AdriTeixeHax/RTSpeed-Hardware/RTSpeed-KiCad/RTSpeed-KiCad.kicad_pcb

## KiCad design RTSpeed-KiCad/RTSpeed-KiCad.kicad_pcb (2025-10-25)

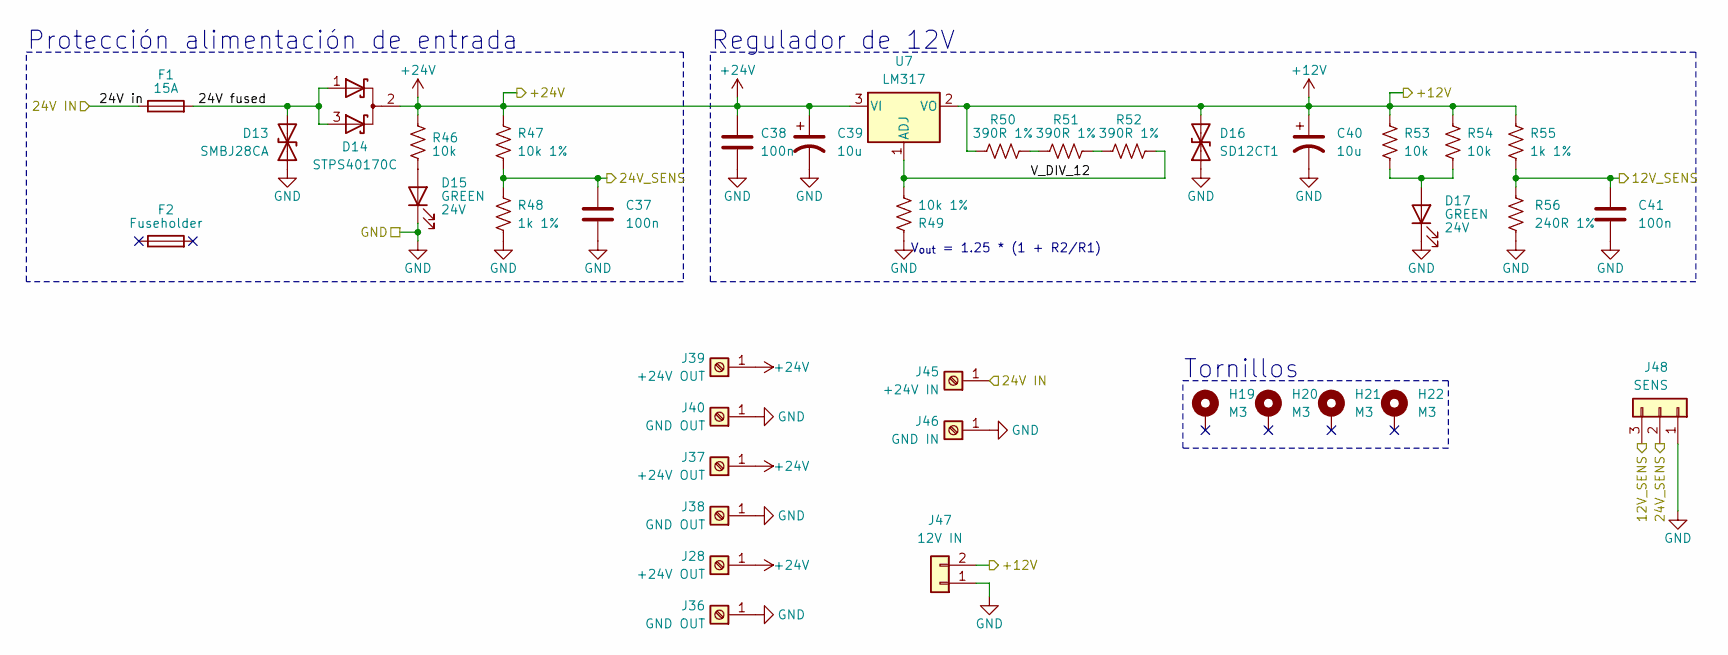
[picture p13: schematic Prot-24V-12V.kicad_sch]

Parts:
C37, C38, C41: 100n; C_0603_1608Metric; LCSC part C5137636
C39, C40: 10u; CP_Elec_4x5.4; LCSC part C72484
D13: SMBJ28CA; D_SMB; LCSC part C151259
D14: STPS40170C; TO-220-3_Vertical; LCSC part C222365
D15, D17: GREEN; LED_0805_2012Metric; LCSC part C965815
D16: SD12CT1; D_SOD-323_HandSoldering; LCSC part C328100
F1: 15A; Fuseholder_Automotive; LCSC part C151095
F2: Fuseholder; LCSC part C19727305
H19, H20, H21, H22: M3; MountingHole_3.2mm_M3
J28, J37, J39: +24V OUT; MountingHole_2.5mm_Pad_TopBottom
J36, J38, J40: GND OUT; MountingHole_2.5mm_Pad_TopBottom
J45: +24V IN; MountingHole_2.5mm_Pad_TopBottom
J46: GND IN; MountingHole_2.5mm_Pad_TopBottom
J47: 12V IN; JST_PH_B2B-PH-K_1x02_P2.00mm_Vertical
J48: SENS; JST_PH_B3B-PH-K_1x03_P2.00mm_Vertical
R46, R53, R54: 10k; R_0603_1608Metric; LCSC part C126901
R47, R49: 10k 1%; R_0603_1608Metric; LCSC part C126901
R48: 1k 1%; R_0603_1608Metric; LCSC part C103198
R50, R51, R52: 390R 1%; R_0603_1608Metric; LCSC part C3016257
R55: 1k 1%; R_0603_1608Metric; LCSC part C126901
R56: 240R 1%; R_0603_1608Metric; LCSC part C286579
U7: LM317; TO-220-3_Vertical; LCSC part C3014307

Connections:
+12V: C40.1, D16.2 (A2), J47.2, R50.1, R53.1, R54.1, R55.1, U7.2 (VO); also elsewhere on the board
+24V: C38.1, C39.1, D14.2 (K), J28.1, J37.1, J39.1, R46.1, R47.1, U7.3 (VI); also elsewhere on the board
/ADC/CH0: C37.1, J48.2, R47.2, R48.2; also elsewhere on the board
/ADC/CH1: C41.1, J48.3, R55.2, R56.1; also elsewhere on the board
/Protección 24V-12V/24V fused: D13.2 (A2), D14.1 (A), D14.3 (A), F1.2
/Protección 24V-12V/24V in: F1.1, J45.1; also elsewhere on the board
/Protección 24V-12V/V_DIV_12: R49.2, R52.2, U7.1 (ADJ)
GND: C37.2, C38.2, C39.2, C40.2, C41.2, D13.1 (A1), D15.1 (K), D16.1 (A1), D17.1 (K), J36.1, J38.1, J40.1, J46.1, J47.1, J48.1, R48.1, R49.1, R56.2; also elsewhere on the board
unnamed: D15.2 (A), R46.2
unnamed: D17.2 (A), R53.2, R54.2
unnamed: R50.2, R51.1
unnamed: R51.2, R52.1

Notes on the sheet:
Protección alimentación de entrada
V_{out} = 1.25 * (1 + R2/R1)
Regulador de 12V
Tornillos

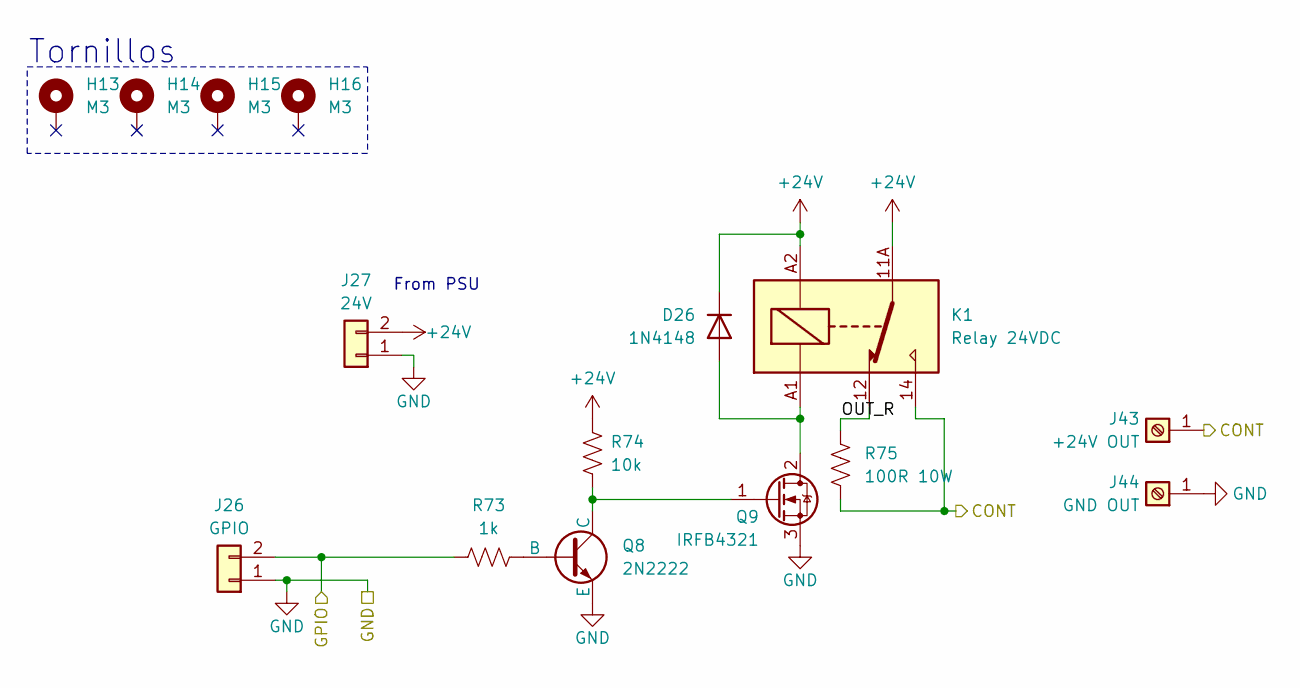
[picture p14: schematic Contactor.kicad_sch]

Parts:
D26: 1N4148; D_DO-35_SOD27_P7.62mm_Horizontal
H13, H14, H15, H16: M3; MountingHole_3.2mm_M3
J26: GPIO; JST_PH_B2B-PH-K_1x02_P2.00mm_Vertical
J27: 24V; Barrier_1x02
J43: +24V OUT; MountingHole_2.5mm_Pad_TopBottom
J44: GND OUT; MountingHole_2.5mm_Pad_TopBottom
K1: Relay 24VDC; Relay_SPDT_RAYEX-L90
Q8: 2N2222; TO-92_Inline
Q9: IRFB4321; TO-220-3_Vertical; LCSC part C2656
R73: 1k; R_Axial_DIN0207_L6.3mm_D2.5mm_P15.24mm_Horizontal
R74: 10k; R_Axial_DIN0207_L6.3mm_D2.5mm_P15.24mm_Horizontal
R75: 100R 10W; R_Power_22x9.5x9.5_P18mm

Connections:
+24V: D26.1 (K), J27.2, K1.11A, K1.11B, K1.A2, R74.1; also elsewhere on the board
/Contactor/OUT_R: K1.12, R75.1
/Microcontrolador/PA10: J26.2, R73.1; also elsewhere on the board
/Protección 24V-12V/24V in: J43.1, K1.14, R75.2; also elsewhere on the board
GND: J26.1, J27.1, J44.1, Q8.3 (E), Q9.3 (S); also elsewhere on the board
unnamed: D26.2 (A), K1.A1, Q9.2 (D)
unnamed: Q8.2 (B), R73.2
unnamed: Q8.1 (C), Q9.1 (G), R74.2

Notes on the sheet:
From PSU
Tornillos

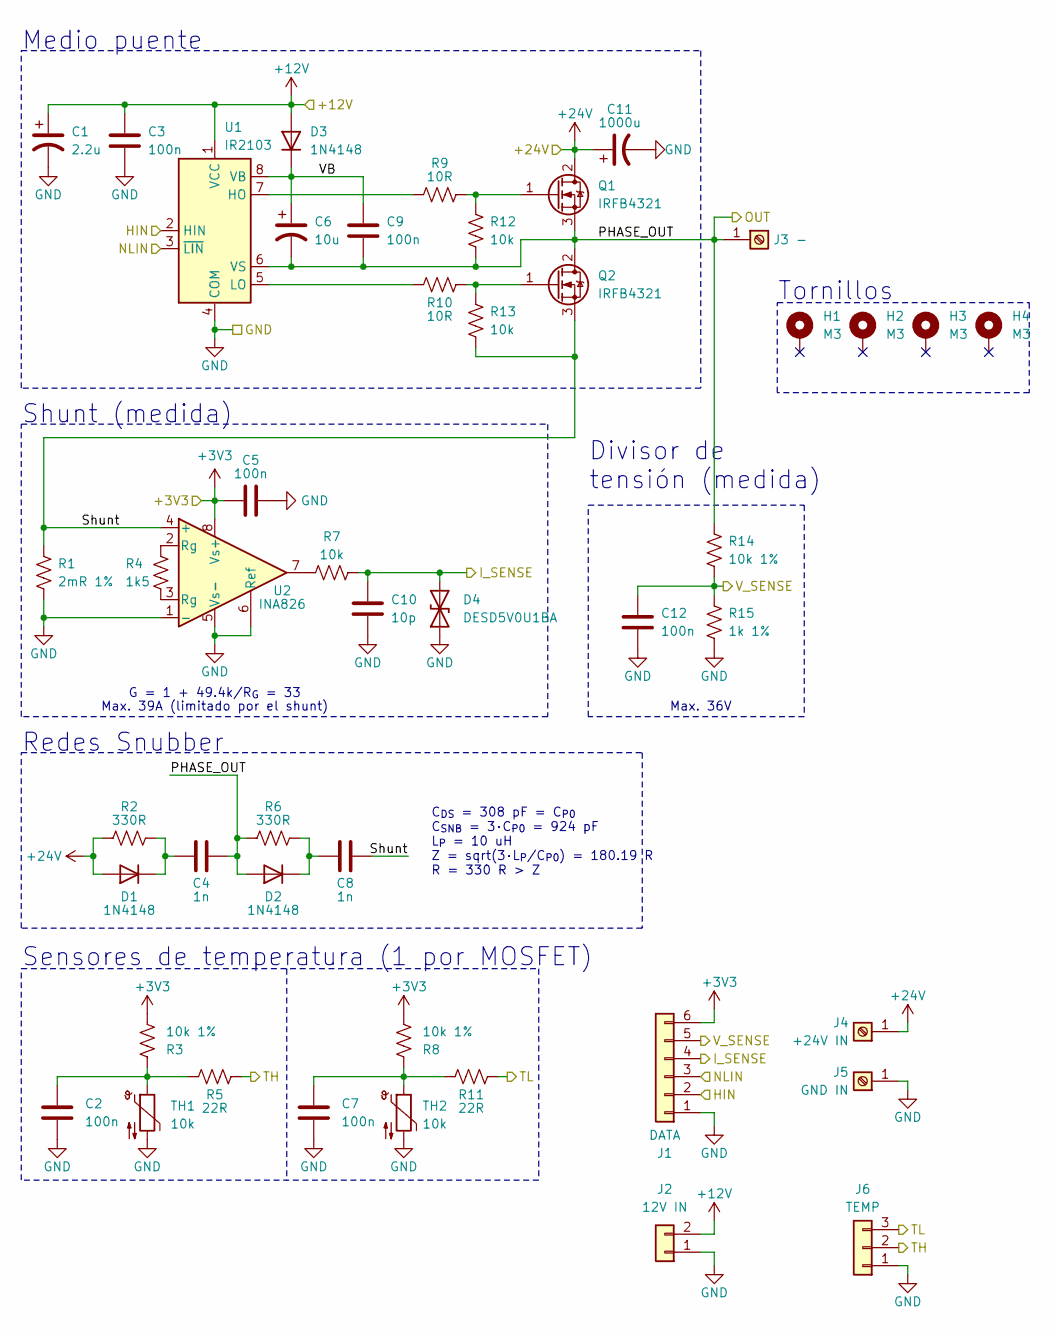
[picture p15: schematic Medio-Puente.kicad_sch, Medio Puente]

Parts:
C1: 2.2u; CP_Elec_4x5.4; LCSC part C72493
C2, C3, C5, C7, C9, C12: 100n; C_0603_1608Metric; LCSC part C5137636
C4, C8: 1n; C_0603_1608Metric; LCSC part C96090
C6: 10u; CP_Elec_4x5.4; LCSC part C72484
C10: 10p; C_0603_1608Metric; LCSC part C376764
C11: 1000u; CP_Radial_D12.5mm_P5.00mm; LCSC part C88743
D1, D2, D3: 1N4148; D_SOD-123; LCSC part C83528
D4: DESD5V0U1BA; D_SOD-323_HandSoldering; LCSC part C460442
H1, H2, H3, H4: M3; MountingHole_3.2mm_M3
J1: DATA; JST_PH_B6B-PH-K_1x06_P2.00mm_Vertical
J2: 12V IN; JST_PH_B2B-PH-K_1x02_P2.00mm_Vertical
J3: -; MountingHole_2.5mm_Pad_TopBottom
J4: +24V IN; MountingHole_2.5mm_Pad_TopBottom
J5: GND IN; MountingHole_2.5mm_Pad_TopBottom
J6: TEMP; JST_PH_B3B-PH-K_1x03_P2.00mm_Vertical
Q1, Q2: IRFB4321; TO-220-3_Vertical; LCSC part C2656
R1: 2mR 1%; R_2512_6332Metric; LCSC part C2994640
R2, R6: 330R; R_0603_1608Metric; LCSC part C2933198
R3, R8, R14: 10k 1%; R_0603_1608Metric; LCSC part C126901
R4: 1k5; R_0603_1608Metric; LCSC part C3016293
R5, R11: 22R; R_0603_1608Metric; LCSC part C163887
R7, R12, R13: 10k; R_0603_1608Metric; LCSC part C126901
R9, R10: 10R; R_0805_2012Metric; LCSC part C3016584
R15: 1k 1%; R_0603_1608Metric; LCSC part C103198
TH1: 10k; temp sensor; LCSC part C84036
TH2: 10k; temp sensor; LCSC part C123383
U1: IR2103; SOIC-8_3.9x4.9mm_P1.27mm; LCSC part C2957
U2: INA826; SOIC-8_3.9x4.9mm_P1.27mm; LCSC part C51631

Connections:
+3V3: C5.1, J1.6, R3.2, R8.2, U2.8 (Vs+); also elsewhere on the board
+12V: C1.1, C3.1, D3.2 (A), J2.2, U1.1 (VCC); also elsewhere on the board
+24V: C11.1, D1.2 (A), J4.1, Q1.2 (D), R2.2; also elsewhere on the board
/ADC/CH2: J6.2, R5.1; also elsewhere on the board
/ADC/CH3: J6.3, R11.1; also elsewhere on the board
/Medio-Puente-U/PHASE_OUT: C4.2, C6.2, C9.2, D2.2 (A), J3.1, Q1.3 (S), Q2.2 (D), R6.2, R12.1, R14.2, U1.6 (VS); also elsewhere on the board
/Medio-Puente-U/Shunt: C8.2, Q2.3 (S), R1.1, R13.1, U2.4 (+)
/Medio-Puente-U/VB: C6.1, C9.1, D3.1 (K), U1.8 (VB)
/Microcontrolador/PA8: J1.3, U1.3 (~LIN); also elsewhere on the board
/Microcontrolador/PA9: J1.2, U1.2 (HIN); also elsewhere on the board
/Microcontrolador/PB0: C12.1, J1.5, R14.1, R15.2; also elsewhere on the board
/Microcontrolador/PB1: C10.2, D4.2 (A2), J1.4, R7.2; also elsewhere on the board
GND: C1.2, C2.2, C3.2, C5.2, C7.2, C10.1, C11.2, C12.2, D4.1 (A1), J1.1, J2.1, J5.1, J6.1, R1.2, R15.1, TH1.2, TH2.2, U1.4 (COM), U2.1 (-), U2.5 (Vs-), U2.6 (Ref); also elsewhere on the board
unnamed: C2.1, R3.1, R5.2, TH1.1
unnamed: C7.1, R8.1, R11.2, TH2.1
unnamed: C4.1, D1.1 (K), R2.1
unnamed: C8.1, D2.1 (K), R6.1
unnamed: Q1.1 (G), R9.2, R12.2
unnamed: Q2.1 (G), R10.1, R13.2
unnamed: R4.1, U2.2 (Rg)
unnamed: R4.2, U2.3 (Rg)
unnamed: R7.1, U2.7
unnamed: R9.1, U1.7 (HO)
unnamed: R10.2, U1.5 (LO)

Parts of its further copies:
C13, C25: 2.2u; CP_Elec_4x5.4; LCSC part C72493
C14, C15, C17, C19, C21, C24, C26, C27, C29, C31, C33, C36: 100n; C_0603_1608Metric; LCSC part C5137636
C16, C20, C28, C32: 1n; C_0603_1608Metric; LCSC part C96090
C18, C30: 10u; CP_Elec_4x5.4; LCSC part C72484
C22, C34: 10p; C_0603_1608Metric; LCSC part C376764
C23, C35: 1000u; CP_Radial_D12.5mm_P5.00mm; LCSC part C88743
D5, D6, D7, D9, D10, D11: 1N4148; D_SOD-123; LCSC part C83528
D8, D12: DESD5V0U1BA; D_SOD-323_HandSoldering; LCSC part C460442
H5, H6, H7, H8, H9, H10, H11, H12: M3; MountingHole_3.2mm_M3
J7, J13: DATA; JST_PH_B6B-PH-K_1x06_P2.00mm_Vertical
J8, J14: 12V IN; JST_PH_B2B-PH-K_1x02_P2.00mm_Vertical
J9, J15: -; MountingHole_2.5mm_Pad_TopBottom
J10, J16: +24V IN; MountingHole_2.5mm_Pad_TopBottom
J11, J17: GND IN; MountingHole_2.5mm_Pad_TopBottom
J12, J18: TEMP; JST_PH_B3B-PH-K_1x03_P2.00mm_Vertical
Q3, Q4, Q5, Q6: IRFB4321; TO-220-3_Vertical; LCSC part C2656
R16, R31: 2mR 1%; R_2512_6332Metric; LCSC part C2994640
R17, R21, R32, R36: 330R; R_0603_1608Metric; LCSC part C2933198
R18, R23, R29, R33, R38, R44: 10k 1%; R_0603_1608Metric; LCSC part C126901
R19, R34: 1k5; R_0603_1608Metric; LCSC part C3016293
R20, R26, R35, R41: 22R; R_0603_1608Metric; LCSC part C163887
R22, R27, R28, R37, R42, R43: 10k; R_0603_1608Metric; LCSC part C126901
R24, R25, R39, R40: 10R; R_0805_2012Metric; LCSC part C3016584
R30, R45: 1k 1%; R_0603_1608Metric; LCSC part C103198
TH3, TH5: 10k; temp sensor; LCSC part C84036
TH4, TH6: 10k; temp sensor; LCSC part C123383
U3, U5: IR2103; SOIC-8_3.9x4.9mm_P1.27mm; LCSC part C2957
U4, U6: INA826; SOIC-8_3.9x4.9mm_P1.27mm; LCSC part C51631

Connections of its further copies:
+3V3: C17.1, C29.1, J7.6, J13.6, R18.2, R23.2, R33.2, R38.2, U4.8 (Vs+), U6.8 (Vs+); also elsewhere on the board
+12V: C13.1, C15.1, C25.1, C27.1, D7.2 (A), D11.2 (A), J8.2, J14.2, U3.1 (VCC), U5.1 (VCC); also elsewhere on the board
+24V: C23.1, C35.1, D5.2 (A), D9.2 (A), J10.1, J16.1, Q3.2 (D), Q5.2 (D), R17.2, R32.2; also elsewhere on the board
/ADC/CH4: J12.2, R20.1; also elsewhere on the board
/ADC/CH5: J12.3, R26.1; also elsewhere on the board
/ADC/CH6: J18.2, R35.1; also elsewhere on the board
/ADC/CH7: J18.3, R41.1; also elsewhere on the board
/Medio-Puente-V/PHASE_OUT: C16.2, C18.2, C21.2, D6.2 (A), J9.1, Q3.3 (S), Q4.2 (D), R21.2, R27.1, R29.2, U3.6 (VS); also elsewhere on the board
/Medio-Puente-V/Shunt: C20.2, Q4.3 (S), R16.1, R28.1, U4.4 (+)
/Medio-Puente-V/VB: C18.1, C21.1, D7.1 (K), U3.8 (VB)
/Medio-Puente-W/PHASE_OUT: C28.2, C30.2, C33.2, D10.2 (A), J15.1, Q5.3 (S), Q6.2 (D), R36.2, R42.1, R44.2, U5.6 (VS); also elsewhere on the board
/Medio-Puente-W/Shunt: C32.2, Q6.3 (S), R31.1, R43.1, U6.4 (+)
/Medio-Puente-W/VB: C30.1, C33.1, D11.1 (K), U5.8 (VB)
/Microcontrolador/PA0: C36.1, J13.5, R44.1, R45.2; also elsewhere on the board
/Microcontrolador/PA1: C34.2, D12.2 (A2), J13.4, R37.2; also elsewhere on the board
/Microcontrolador/PA2: J13.3, U5.3 (~LIN); also elsewhere on the board
/Microcontrolador/PA3: J13.2, U5.2 (HIN); also elsewhere on the board
/Microcontrolador/PA4: C24.1, J7.5, R29.1, R30.2; also elsewhere on the board
/Microcontrolador/PA5: C22.2, D8.2 (A2), J7.4, R22.2; also elsewhere on the board
/Microcontrolador/PA6: J7.3, U3.3 (~LIN); also elsewhere on the board
/Microcontrolador/PA7: J7.2, U3.2 (HIN); also elsewhere on the board
GND: C13.2, C14.2, C15.2, C17.2, C19.2, C22.1, C23.2, C24.2, C25.2, C26.2, C27.2, C29.2, C31.2, C34.1, C35.2, C36.2, D8.1 (A1), D12.1 (A1), J7.1, J8.1, J11.1, J12.1, J13.1, J14.1, J17.1, J18.1, R16.2, R30.1, R31.2, R45.1, TH3.2, TH4.2, TH5.2, TH6.2, U3.4 (COM), U4.1 (-), U4.5 (Vs-), U4.6 (Ref), U5.4 (COM), U6.1 (-), U6.5 (Vs-), U6.6 (Ref); also elsewhere on the board
unnamed: C14.1, R18.1, R20.2, TH3.1
unnamed: C19.1, R23.1, R26.2, TH4.1
unnamed: C26.1, R33.1, R35.2, TH5.1
unnamed: C31.1, R38.1, R41.2, TH6.1
unnamed: C16.1, D5.1 (K), R17.1
unnamed: C20.1, D6.1 (K), R21.1
unnamed: C28.1, D9.1 (K), R32.1
unnamed: C32.1, D10.1 (K), R36.1
unnamed: Q3.1 (G), R24.2, R27.2
unnamed: Q4.1 (G), R25.1, R28.2
unnamed: Q5.1 (G), R39.2, R42.2
unnamed: Q6.1 (G), R40.1, R43.2
unnamed: R19.1, U4.2 (Rg)
unnamed: R19.2, U4.3 (Rg)
unnamed: R22.1, U4.7
unnamed: R34.1, U6.2 (Rg)
unnamed: R34.2, U6.3 (Rg)
unnamed: R37.1, U6.7
unnamed: R24.1, U3.7 (HO)
unnamed: R25.2, U3.5 (LO)
unnamed: R39.1, U5.7 (HO)
unnamed: R40.2, U5.5 (LO)

Notes on the sheet:
Max. 39A (limitado por el shunt)
Medio puente
C_{DS} = 308 pF = C_{P0} C_{SNB} = 3·C_{P0} = 924 pF L_{P} = 10 uH Z = sqrt(3·L_{P}/C_{P0}) = 180.19 R R = 330 R > Z
Divisor de tensión (medida)
Max. 36V
Redes Snubber
Shunt (medida)
Tornillos
G = 1 + 49.4k/R_{G} = 33
Sensores de temperatura (1 por MOSFET)

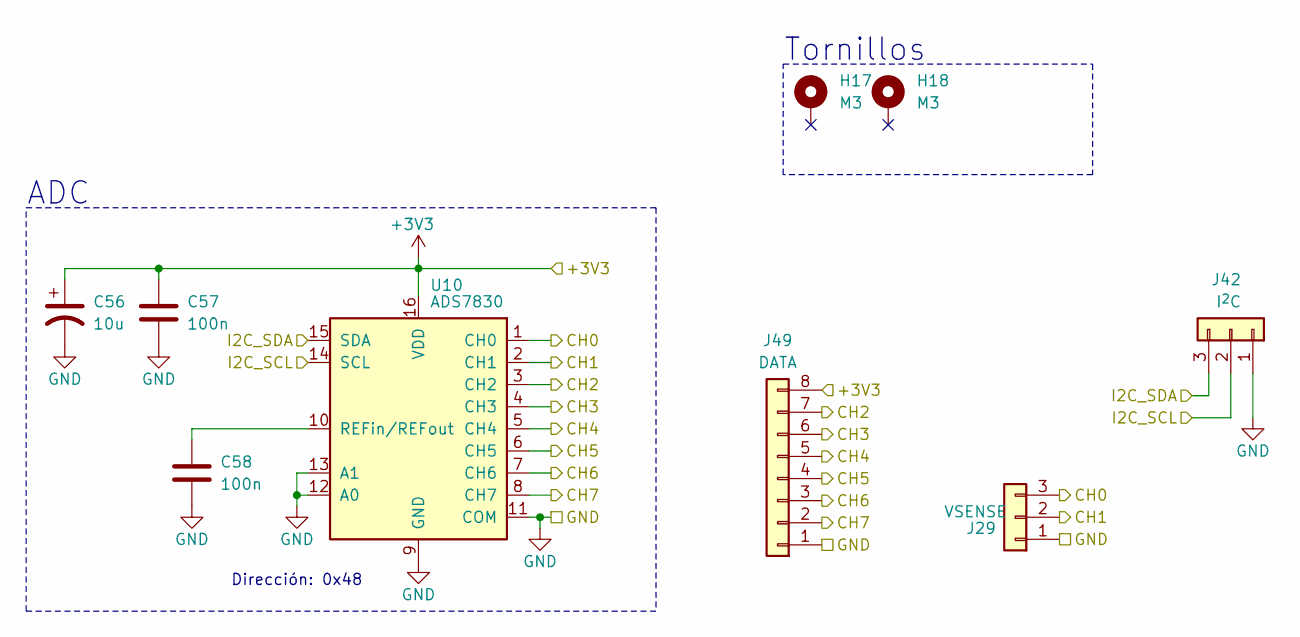
[picture p16: schematic ADC.kicad_sch]

Parts:
C56: 10u; CP_Elec_4x5.4; LCSC part C72484
C57, C58: 100n; C_0603_1608Metric; LCSC part C5137636
H17, H18: M3; MountingHole_3.2mm_M3
J29: VSENSE; JST_PH_B3B-PH-K_1x03_P2.00mm_Vertical
J42: I^{2}C; JST_PH_B3B-PH-K_1x03_P2.00mm_Vertical
J49: DATA; JST_PH_B8B-PH-K_1x08_P2.00mm_Vertical
U10: ADS7830; TSSOP-16_4.4x5mm_P0.65mm; LCSC part C161747

Connections:
+3V3: C56.1, C57.1, J49.8, U10.16 (VDD); also elsewhere on the board
/ADC/CH0: J29.3, U10.1 (CH0); also elsewhere on the board
/ADC/CH1: J29.2, U10.2 (CH1); also elsewhere on the board
/ADC/CH2: J49.7, U10.3 (CH2); also elsewhere on the board
/ADC/CH3: J49.6, U10.4 (CH3); also elsewhere on the board
/ADC/CH4: J49.5, U10.5 (CH4); also elsewhere on the board
/ADC/CH5: J49.4, U10.6 (CH5); also elsewhere on the board
/ADC/CH6: J49.3, U10.7 (CH6); also elsewhere on the board
/ADC/CH7: J49.2, U10.8 (CH7); also elsewhere on the board
/Microcontrolador/I2C_SCL: J42.2, U10.14 (SCL); also elsewhere on the board
/Microcontrolador/I2C_SDA: J42.3, U10.15 (SDA); also elsewhere on the board
GND: C56.2, C57.2, C58.2, J29.1, J42.1, J49.1, U10.9 (GND), U10.11 (COM), U10.12 (A0), U10.13 (A1); also elsewhere on the board
unnamed: C58.1, U10.10 (REFin/REFout)

Notes on the sheet:
ADC
Dirección: 0x48
Tornillos

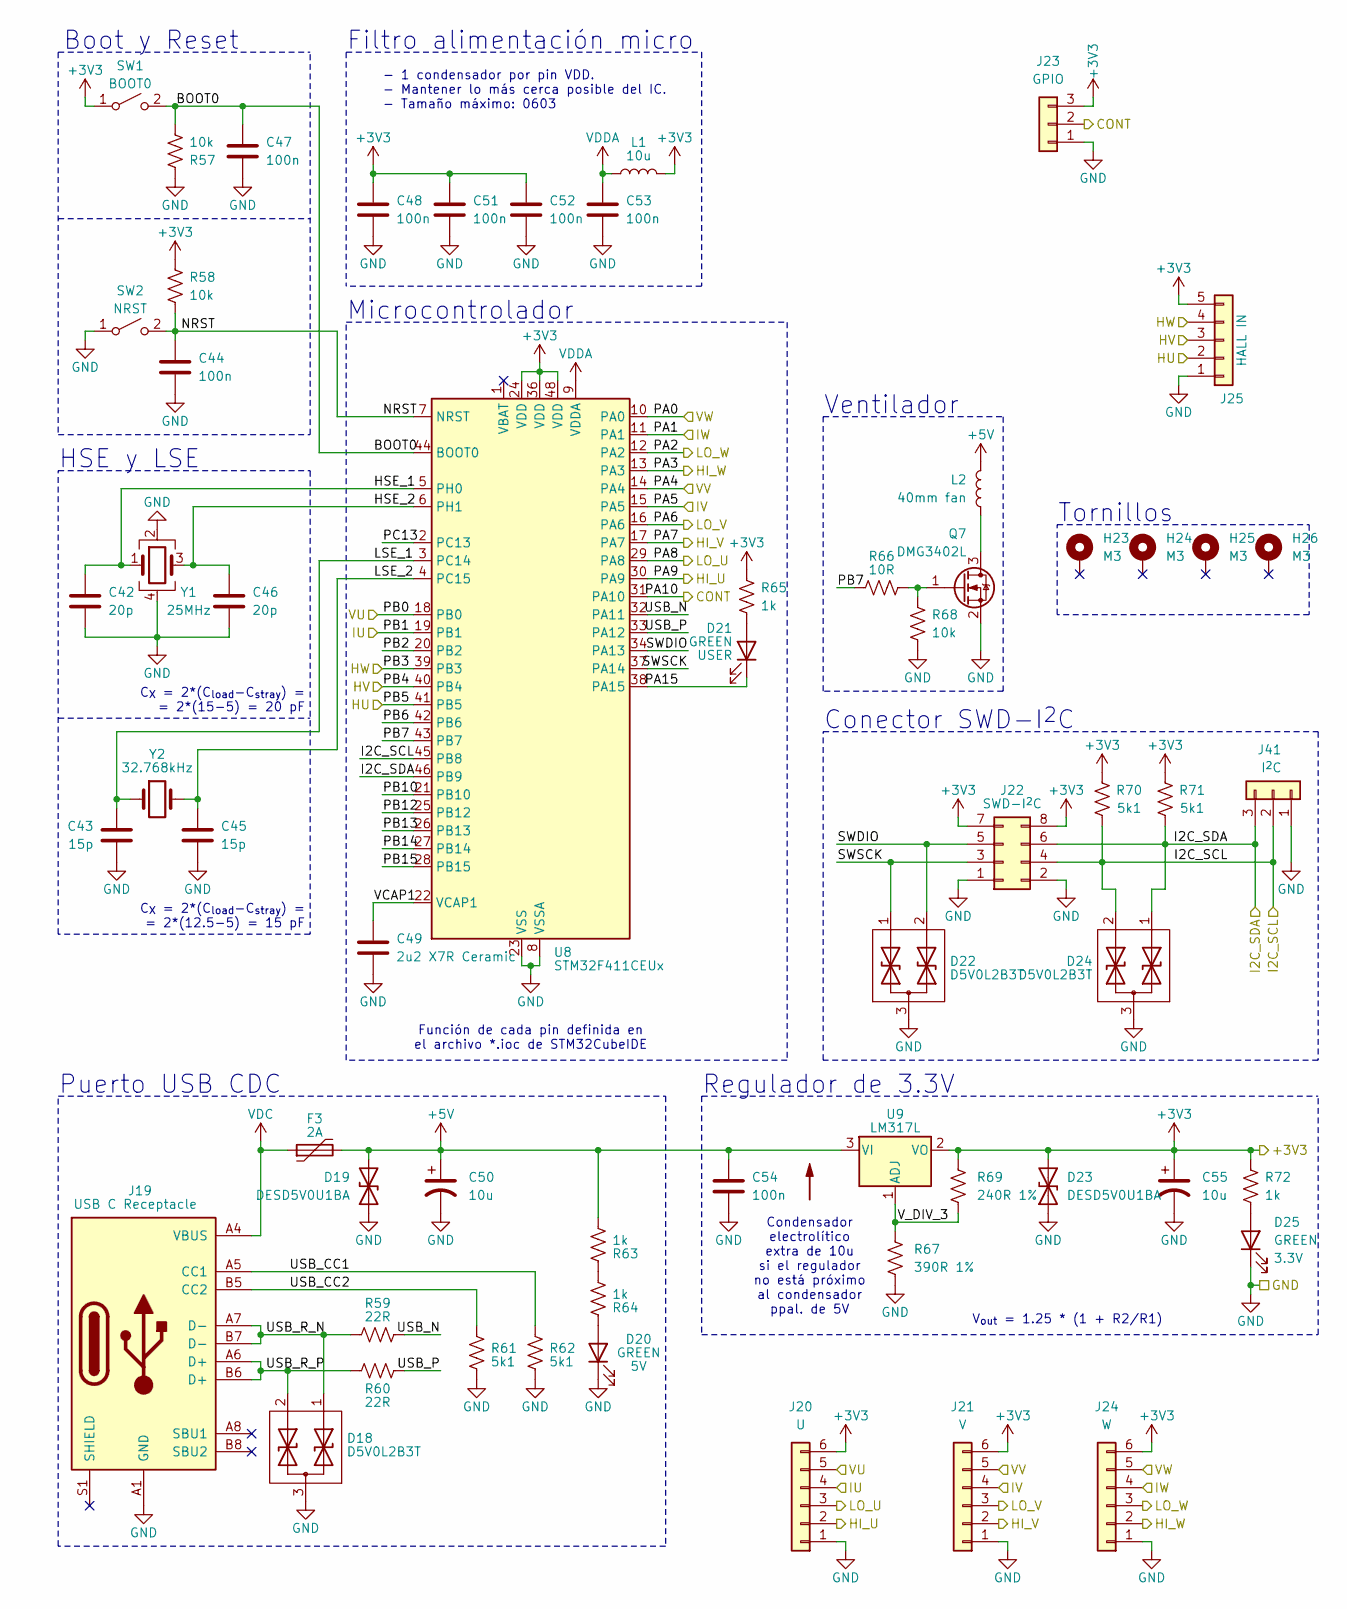
[picture p17: schematic Microcontrolador.kicad_sch]

Parts:
C42, C46: 20p; C_0603_1608Metric; LCSC part C376774
C43, C45: 15p; C_0603_1608Metric; LCSC part C1644
C44, C47, C48, C51, C52, C53, C54: 100n; C_0603_1608Metric; LCSC part C5137636
C49: 2u2 X7R Ceramic; C_0603_1608Metric; LCSC part C7393903
C50: 10u; CP_Elec_4x5.4; LCSC Part C72485
C55: 10u; CP_Elec_4x5.4; LCSC part C72484
D18, D22, D24: D5V0L2B3T; SOT-523; LCSC part C526508
D19, D23: DESD5V0U1BA; D_SOD-323_HandSoldering; LCSC part C460442
D20, D21, D25: GREEN; LED_0805_2012Metric; LCSC part C965815
F3: 2A; Fuse_1812_4532Metric; LCSC part C2649915
H23, H24, H25, H26: M3; MountingHole_3.2mm_M3
J19: USB C Receptacle; USB_C_Receptacle_XKB_U262-16XN-4BVC11; LCSC part C2765186
J20: U; JST_PH_B6B-PH-K_1x06_P2.00mm_Vertical
J21: V; JST_PH_B6B-PH-K_1x06_P2.00mm_Vertical
J22: SWD-I^{2}C; PinHeader_2x04_P2.54mm_Vertical; LCSC part C492432
J23: GPIO; JST_PH_B3B-PH-K_1x03_P2.00mm_Vertical
J24: W; JST_PH_B6B-PH-K_1x06_P2.00mm_Vertical
J25: HALL IN; JST_PH_B5B-PH-K_1x05_P2.00mm_Vertical; LCSC part C157923
J41: I^{2}C; JST_PH_B3B-PH-K_1x03_P2.00mm_Vertical
L1: 10u; L_0805_2012Metric; LCSC part C99366
L2: 40mm fan; JST_PH_B2B-PH-K_1x02_P2.00mm_Vertical; LCSC part C131337
Q7: DMG3402L; SOT-23; LCSC part C3647055
R57, R58, R68: 10k; R_0603_1608Metric; LCSC part C126901
R59, R60: 22R; R_0603_1608Metric; LCSC part C163887
R61, R62: 5k1; R_0603_1608Metric; LCSC part C2907114
R63, R64, R65, R72: 1k; R_0603_1608Metric; LCSC part C126901
R66: 10R; R_0805_2012Metric; LCSC part C3016584
R67: 390R 1%; R_0603_1608Metric; LCSC part C3016257
R69: 240R 1%; R_0603_1608Metric; LCSC part C286579
R70, R71: 5k1; R_0603_1608Metric; LCSC part C126901
SW1: BOOT0; SPDT; LCSC part C455282
SW2: NRST; SPDT; LCSC part C455282
U8: STM32F411CEUx; QFN-48-1EP_7x7mm_P0.5mm_EP5.6x5.6mm; LCSC part C60420
U9: LM317L; SOT-89-3; LCSC part C112537
Y1: 25MHz; Oscillator_SMD_Abracon_ASE-4Pin_3.2x2.5mm; LCSC part C2901686
Y2: 32.768kHz; Crystal_SMD_3215-2Pin_3.2x1.5mm; LCSC part C97606

Connections:
+3V3: C48.1, C51.1, C52.1, C55.1, D23.2 (A2), J20.6, J21.6, J22.7, J22.8, J23.3, J24.6, J25.5, L1.2, R58.1, R65.1, R69.1, R70.2, R71.2, R72.1, SW1.1 (A), U8.24 (VDD), U8.36 (VDD), U8.48 (VDD), U9.2 (VO); also elsewhere on the board
+5V: C50.1, C54.1, D19.2 (A2), F3.2, L2.1, R63.1, U9.3 (VI)
/Microcontrolador/BOOT0: C47.2, R57.2, SW1.2 (B), U8.44 (BOOT0)
/Microcontrolador/HSE_1: C42.1, U8.5 (PH0), Y1.1
/Microcontrolador/HSE_2: C46.1, U8.6 (PH1), Y1.3
/Microcontrolador/I2C_SCL: D24.2, J22.4, J41.2, R70.1, U8.45 (PB8); also elsewhere on the board
/Microcontrolador/I2C_SDA: D24.1, J22.6, J41.3, R71.1, U8.46 (PB9); also elsewhere on the board
/Microcontrolador/LSE_1: C43.1, U8.3 (PC14), Y2.1
/Microcontrolador/LSE_2: C45.1, U8.4 (PC15), Y2.2
/Microcontrolador/NRST: C44.2, R58.2, SW2.2 (B), U8.7 (NRST)
/Microcontrolador/PA0: J24.5, U8.10 (PA0); also elsewhere on the board
/Microcontrolador/PA1: J24.4, U8.11 (PA1); also elsewhere on the board
/Microcontrolador/PA2: J24.3, U8.12 (PA2); also elsewhere on the board
/Microcontrolador/PA3: J24.2, U8.13 (PA3); also elsewhere on the board
/Microcontrolador/PA4: J21.5, U8.14 (PA4); also elsewhere on the board
/Microcontrolador/PA5: J21.4, U8.15 (PA5); also elsewhere on the board
/Microcontrolador/PA6: J21.3, U8.16 (PA6); also elsewhere on the board
/Microcontrolador/PA7: J21.2, U8.17 (PA7); also elsewhere on the board
/Microcontrolador/PA8: J20.3, U8.29 (PA8); also elsewhere on the board
/Microcontrolador/PA9: J20.2, U8.30 (PA9); also elsewhere on the board
/Microcontrolador/PA10: J23.2, U8.31 (PA10); also elsewhere on the board
/Microcontrolador/PA15: D21.1 (K), U8.38 (PA15)
/Microcontrolador/PB0: J20.5, U8.18 (PB0); also elsewhere on the board
/Microcontrolador/PB1: J20.4, U8.19 (PB1); also elsewhere on the board
/Microcontrolador/PB2: U8.20 (PB2)
/Microcontrolador/PB3: J25.4, U8.39 (PB3); also elsewhere on the board
/Microcontrolador/PB4: J25.3, U8.40 (PB4); also elsewhere on the board
/Microcontrolador/PB5: J25.2, U8.41 (PB5); also elsewhere on the board
/Microcontrolador/PB6: U8.42 (PB6)
/Microcontrolador/PB7: R66.1, U8.43 (PB7)
/Microcontrolador/PB10: U8.21 (PB10)
/Microcontrolador/PB12: U8.25 (PB12)
/Microcontrolador/PB13: U8.26 (PB13)
/Microcontrolador/PB14: U8.27 (PB14)
/Microcontrolador/PB15: U8.28 (PB15)
/Microcontrolador/PC13: U8.2 (PC13)
/Microcontrolador/SWDIO: D22.2, J22.5, U8.34 (PA13)
/Microcontrolador/SWSCK: D22.1, J22.3, U8.37 (PA14)
/Microcontrolador/USB_CC1: J19.A5 (CC1), R62.2
/Microcontrolador/USB_CC2: J19.B5 (CC2), R61.1
/Microcontrolador/USB_N: R59.2, U8.32 (PA11)
/Microcontrolador/USB_P: R60.2, U8.33 (PA12)
/Microcontrolador/USB_R_N: D18.1, J19.A7 (D-), J19.B7 (D-), R59.1
/Microcontrolador/USB_R_P: D18.2, J19.A6 (D+), J19.B6 (D+), R60.1
/Microcontrolador/VCAP1: C49.1, U8.22 (VCAP1)
/Microcontrolador/V_DIV_3: R67.1, R69.2, U9.1 (ADJ)
GND: C42.2, C43.2, C44.1, C45.2, C46.2, C47.1, C48.2, C49.2, C50.2, C51.2, C52.2, C53.2, C54.2, C55.2, D18.3, D19.1 (A1), D20.1 (K), D22.3, D23.1 (A1), D24.3, D25.1 (K), J19.A1 (GND), J19.A12 (GND), J19.B1 (GND), J19.B12 (GND), J20.1, J21.1, J22.1, J22.2, J23.1, J24.1, J25.1, J41.1, Q7.2 (S), R57.1, R61.2, R62.1, R67.2, R68.1, SW2.1 (A), U8.8 (VSSA), U8.23 (VSS), U8.35 (VSS), U8.47 (VSS), U8.49 (VSS), Y1.2, Y1.4; also elsewhere on the board
unnamed: D20.2 (A), R64.2
unnamed: D21.2 (A), R65.2
unnamed: D25.2 (A), R72.2
unnamed: L2.2, Q7.3 (D)
unnamed: Q7.1 (G), R66.2, R68.2
unnamed: R63.2, R64.1
VDC: F3.1, J19.A4 (VBUS), J19.A9 (VBUS), J19.B4 (VBUS), J19.B9 (VBUS)
VDDA: C53.1, L1.1, U8.9 (VDDA)

Notes on the sheet:
Microcontrolador
Función de cada pin definida en el archivo *.ioc de STM32CubeIDE
- 1 condensador por pin VDD. - Mantener lo más cerca posible del IC. - Tamaño máximo: 0603
Ventilador
C_{X} = 2*(C_{load}-C_{stray}) = = 2*(12.5-5) = 15 pF
Condensador electrolítico extra de 10u si el regulador no está próximo al condensador ppal. de 5V
Conector SWD-I^{2}C
C_{X} = 2*(C_{load}-C_{stray}) = = 2*(15-5) = 20 pF
HSE y LSE
Puerto USB CDC
Regulador de 3.3V
Boot y Reset
Tornillos
Filtro alimentación micro
V_{out} = 1.25 * (1 + R2/R1)

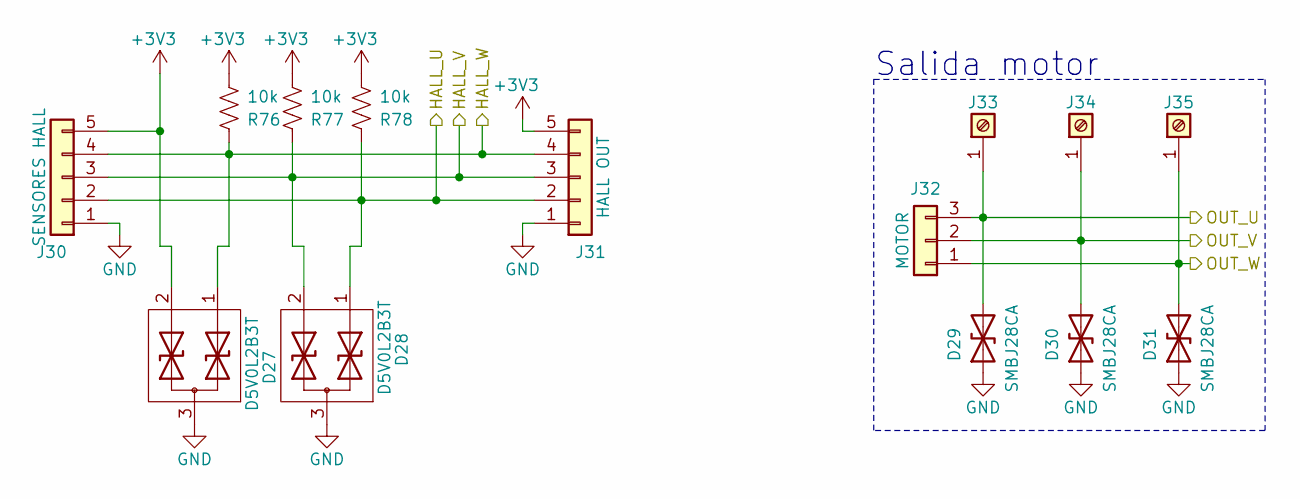
[picture p18: schematic Motor.kicad_sch]

Parts:
D27, D28: D5V0L2B3T; SOT-523; LCSC part C526508
D29, D30, D31: SMBJ28CA; D_SMB; LCSC part C151259
J30: SENSORES HALL; JST_PH_S5B-PH-K_1x05_P2.00mm_Horizontal; LCSC part C157923
J31: HALL OUT; JST_PH_B5B-PH-K_1x05_P2.00mm_Vertical; LCSC part C157923
J32: MOTOR; Barrier_1x03; LCSC part C395959
J33, J34, J35: -; MountingHole_2.5mm_Pad_TopBottom
R76, R77, R78: 10k; R_0603_1608Metric; LCSC part C126901

Connections:
+3V3: D27.2, J30.5, J31.5, R76.2, R77.2, R78.2; also elsewhere on the board
/Medio-Puente-U/PHASE_OUT: D29.2 (A2), J32.3, J33.1; also elsewhere on the board
/Medio-Puente-V/PHASE_OUT: D30.2 (A2), J32.2, J34.1; also elsewhere on the board
/Medio-Puente-W/PHASE_OUT: D31.2 (A2), J32.1, J35.1; also elsewhere on the board
/Microcontrolador/PB3: D27.1, J30.4, J31.4, R76.1; also elsewhere on the board
/Microcontrolador/PB4: D28.2, J30.3, J31.3, R77.1; also elsewhere on the board
/Microcontrolador/PB5: D28.1, J30.2, J31.2, R78.1; also elsewhere on the board
GND: D27.3, D28.3, D29.1 (A1), D30.1 (A1), D31.1 (A1), J30.1, J31.1; also elsewhere on the board

Notes on the sheet:
Salida motor

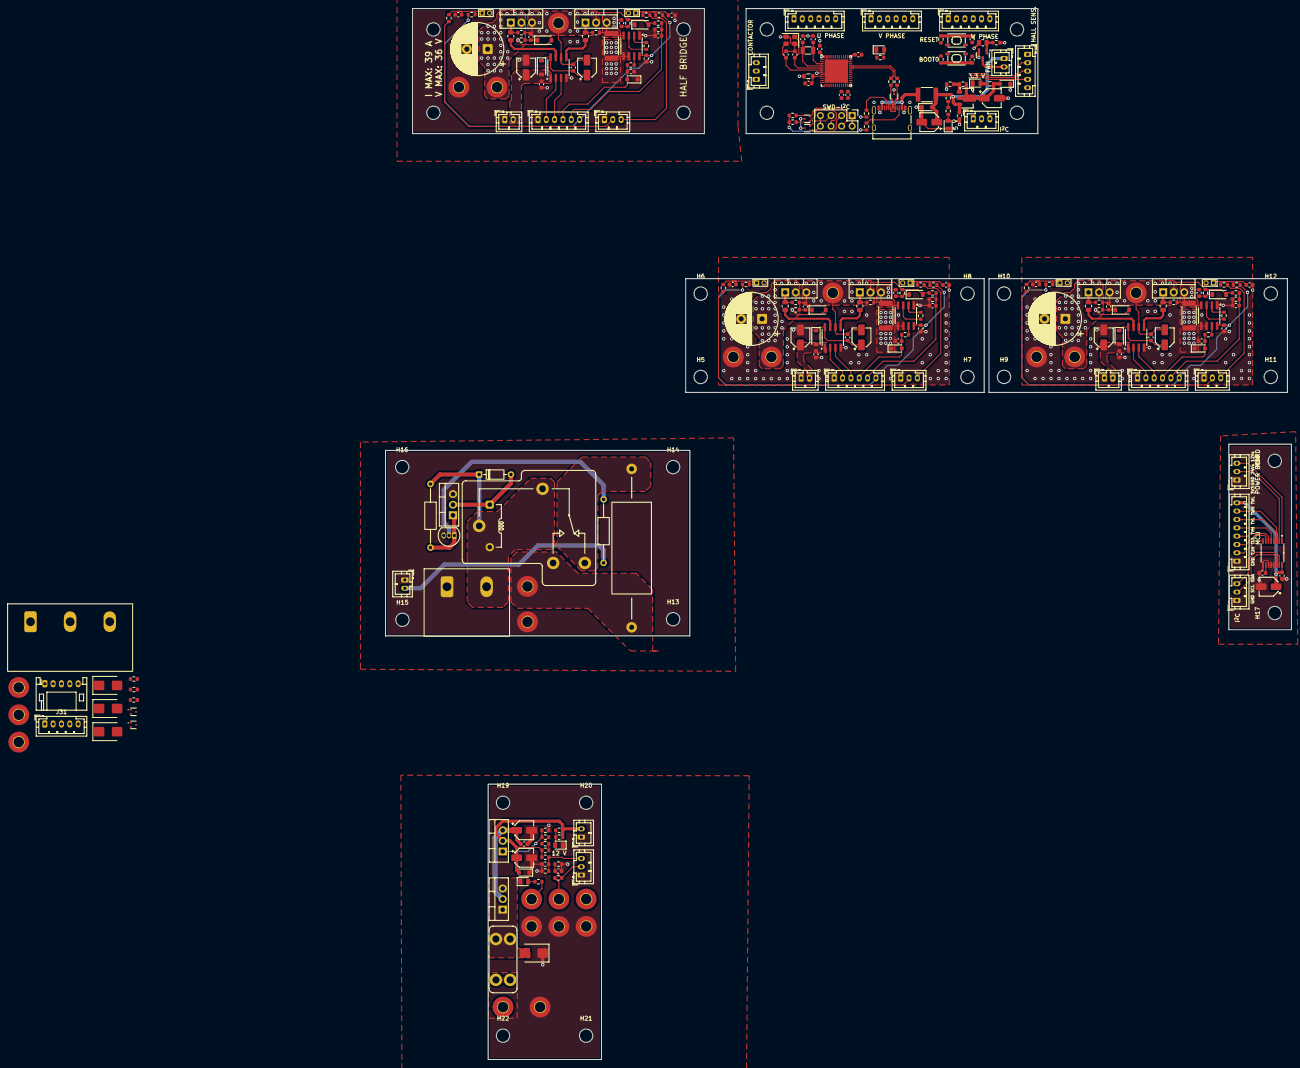
[picture p19: board RTSpeed-KiCad.kicad_pcb from above]

Board: 2 copper layers, 217.3 x 252.1 mm, 276 parts (0 on the bottom side), 111 nets.
