AdriTeixeHax/RTSpeed-Hardware/(commit log)

2025-10-05 Added automatic contactor PCB
    [BOM.csv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]
2025-10-11 Contactor control pcb
    [RTSpeed-KiCad.kicad_pcb, contactorControl.kicad_sch]
2025-10-25 PCB redesign (not final)
    [ADC.kicad_sch, BOM.csv, Contactor.kicad_sch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]
